mcferront/ss_minnow/(list of files, drawings)

Other design files:
PCB/ColorGenerator.dch
PCB/ColorGenerator.dip
PCB/Island.dch
PCB/Island.dip
PCB/MaryAnn.dch
PCB/MaryAnn_1bit.dch
