mcferront/ss_minnow/Gilligan/memory.asm

MEM_ZP_TEMP_1 = $00
MEM_ZP_TEMP_2 = $01
MEM_ZP_TEMP_3 = $02
MEM_ZP_TEMP_4 = $03

MEM_ZP_TEMP_5 = $04
MEM_ZP_TEMP_6 = $05

MEM_GLOBAL_START = $ff

; stack 	  (0x100 - 0x1ff) (6502 REQ)
MEM_STACK_START = $0100
MEM_STACK_END   = $01ff
