mcferront/ss_minnow/(commit log)

2018-04-17 Initial Checkin
    [Island.dch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]
2018-04-18 Fixed routing errors and BUS_SWITCH component pattern errors
    [Island.dch, Island.dip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]
2018-05-16 Text updates to schematic. Update status.md to reflect parts on order
    [Island.dch, Island.dip]
2018-05-31 Updated next steps. Minor name changes to schematic
    [MaryAnn.dch]
2018-06-12 Implemented Composite NTSC sync timings Fixed a gfx adapter pin in Island.dch Updated todo with latest bugs from getting MaryAnn to work
    [Island.dch]
2018-06-15 Trying to fix the timing Using .3v front porch now Almost syncs but not quite Added some more docs which help explain timings
    [main.asm]
2018-06-22 Timings are corrected so B/W bars appear, two monitors tested; both stable
    [macros.asm, main.asm, sync_pulse.asm]
2018-06-28 Fixed timing with colorbars, they now work
    [macros.asm, main.asm, sync_pulse.asm]
2018-06-29 4-bit color DAC preparation Removed 3v testing code Added code generation for all 4-bit colors
2018-07-04 Fix MaryAnn bug: GREEN_LO was defined incorrectly. Also, updated status.md to reflect new DAC
    [macros.asm]
2018-08-22 Schematic for ColorGenerator
    [ColorGenerator.dch, ColorGenerator.dip]
2018-08-23 Finished schematic of color generator and created Gerber files
    [ColorGenerator.dch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]
2018-09-06 One bit schematic for Mary Ann testing
    [MaryAnn_1bit.dch]
2018-09-07 Wrote per pixel code tile writing code, finished schematics
    [MaryAnn_1bit.dch]
2018-09-19 Status update, minor bug fixes
    [MaryAnn_1bit.dch]
2018-10-04 Hsync and Vsync work with per pixel color format One bit test color doesn't show up yet (all black) - need to recheck wiring and schematics
    [macros.asm, main.asm, sync_pulse.asm]
2018-10-25 Code fixes so colors sync, checkerboard pixel pattern, updated status
    [MaryAnn_1bit.dch]
2018-10-29 Improved hsync/vsync timing pulses
    [MaryAnn_1bit.dch]
2018-11-29 continued work trying to get color sync - removed double buffer shift registers
    [MaryAnn_1bit.dch]
2018-11-30 New design/code to try and get per pixel color working
    [MaryAnn_1bit.dch]
